burakbalci51/G-Mod-l-Enerji-zleme/TEKNİK RAPOR.docx

TEKNİK RAPOR

ESP32 + Home Assistant Tabanlı Akıllı Enerji Sayacı Tasarımı, Üretimi ve Entegrasyonu

Hazırlayan: Burak Balcı
Konu: Konut/Ofis genelinde elektrik tüketiminin ölçülmesi, görselleştirilmesi ve analiz edilmesi amacıyla geliştirilen IoT tabanlı akıllı enerji sayacı sistemi
Kapsam: Donanım tasarımı, montaj, güvenlik yaklaşımı, ESPHome ile Home Assistant entegrasyonu, saha kurulumu ve dashboard yapılandırma prensipleri

1. Amaç ve Gerekçe

Bu çalışmanın amacı; konut veya ofis ortamında elektrik tüketimini anlık ve geçmişe dönük olarak izlemeyi mümkün kılan, yerel ağ üzerinde çalışan ve mobil uygulama üzerinden erişilebilen akıllı enerji sayacı sistemi geliştirmektir. Enerji verimliliği ve maliyet optimizasyonu açısından temel yaklaşım, tüketimin ölçülebilir ve analiz edilebilir hâle getirilmesidir. Bu sistem ile:

- Anlık güç tüketimi (W)
- Enerji tüketimi (Wh / kWh)
- Gerilim (V), akım (A), frekans (Hz) ve güç faktörü (PF)
- Günlük/haftalık/aylık/yıllık trendler

Home Assistant üzerinden izlenebilmekte, grafiklerle raporlanabilmekte ve tüketim karakteristikleri çıkarılabilmektedir.

2. Sistem Genel Mimarisi

Sistem üç ana bileşenden oluşmaktadır:

1. Ölçüm Katmanı (Enerji Ölçüm Modülü): AC ölçümler için JSY-MK-194G enerji ölçüm modülü kullanılmıştır. Modül; akım pensesi (CT clamp) ile akımı, izolasyonlu transformatör ile şebeke gerilimini ölçmekte ve dahili hesaplama devreleri üzerinden güç/enerji parametrelerini üretmektedir.
2. İletişim ve Veri Katmanı (Mikrodenetleyici): ESP32 mikrodenetleyici; Modbus protokolü üzerinden ölçüm modülünden verileri okumakta ve WiFi üzerinden Home Assistant’a iletmektedir.
3. Görselleştirme ve Analiz Katmanı (Home Assistant + Dashboard): Home Assistant üzerinde sensör verileri kaydedilmekte, istatistiksel hesaplamalar yapılmakta ve kullanıcıya dashboard üzerinden sunulmaktadır. Ek olarak cihaz üzerinde bir OLED ekran ile anlık değerler yerel olarak görüntülenmektedir.

3. Kullanılan Malzemeler ve Araçlar

3.1. Elektronik Bileşenler

- JSY-MK-194G enerji ölçüm modülü (CT clamp dahil)
- ESP32 Wemos D1 Mini geliştirme kartı
- Meanwell APV-8-5 (5V, 8W) güç kaynağı
- SSD1306 0.96” I2C OLED ekran
- Perfboard (delikli pertinaks)
- 26 AWG silikon kılıflı kablo, tek damarlı bakır tel
- 2.54 mm jumper konnektörler (erkek/dişi)
- 4-pin JST XH 2.54 mm PCB konnektörü (dişi soket ve kablolu set)
- 2-pin 5.08 mm klemens terminal blok
- Isı büzüşmeli makaron
- Fişli güç kablosu (geri dönüştürülebilir)

3.2. Mekanik / Montaj Malzemeleri

- 3D baskı muhafaza ve kapak (alternatif: elektrik buatı)
- M3 pirinç dişli insertler (brass threaded inserts)
- M3x10 mm vidalar
- (Opsiyonel) Kablo rakoru (cable gland)

3.3. Araçlar

- Havya (insert yerleştirme için yaklaşık 230°C)
- Sıcak silikon
- Tornavida, pense ve temel el aletleri

4. AC Enerji Ölçümünün Teknik Dayanağı

AC sistemlerde güç hesabı, DC sistemlere göre daha karmaşıktır. DC’de güç P=V×I iken, AC’de yük tipine bağlı olarak güç faktörü değişmekte ve gerçek güç/enerji hesabı bu bileşenle birlikte değerlendirilmelidir. Bu nedenle ölçüm doğruluğu ve güvenilirliği için doğrudan akım pensesini ESP32’ye bağlayarak hesap yapmak yerine, güç faktörünü de dikkate alan bir enerji ölçüm modülü kullanılmıştır.

JSY-MK-194G modülü; ölçtüğü akım ve gerilim verilerinden hareketle güç, enerji ve ilgili parametreleri dahili olarak üretmekte ve Modbus üzerinden dış bir kontrol birimi (ESP32) tarafından okunabilir hâle getirmektedir. Bu yaklaşım; yazılım tarafını sadeleştirir, hatayı azaltır ve ölçüm tutarlılığını artırır.

5. Elektronik Bağlantı Tasarımı

5.1. Düşük Gerilim ve Haberleşme Bağlantıları

- ESP32’nin 3V3 ve GND pinleri ölçüm modülünün VCC ve GND terminallerine bağlanmıştır.
- Modbus iletişimi için:
  - Modül TX → ESP32 GPIO16
  - Modül RX → ESP32 GPIO17
- OLED ekran bağlantıları:
  - VCC → 3V3
  - GND → GND
  - SCL → GPIO22
  - SDA → GPIO21
- 5V güç kaynağı:
  - +5V → ESP32 5V girişi
  - GND → ESP32 GND

5.2. Şebeke (Mains) Bağlantıları – Güvenlik Uyarısı

Şebeke gerilimi yüksek risk içerir. Bu rapor bir “bilgilendirme ve tasarım dokümantasyonu” niteliğindedir. Uygulama yapılacaksa mevzuat, standartlar ve iş güvenliği kuralları çerçevesinde hareket edilmelidir. Şebeke tarafında işlem yapılması gerekiyorsa yetkin kişilerce uygulanmalıdır.

Şebeke bağlantı prensibi:

- Güç kablosundan gelen faz ve nötr;
  - Güç kaynağının girişine
  - Ölçüm modülünün L ve N terminallerine paralel bağlanmıştır.

6. Devre Kartı Üretimi ve Kablolama Yaklaşımı

Kalıcı ve düzenli bağlantılar için bileşenler perfboard üzerine monte edilmiştir. Uygulama adımları:

- Perfboard 54×74 mm ölçülerinde hazırlanmıştır.
- ESP32 kartına erkek pinler lehimlenmiş, perfboard üzerine dişi jumper ile oturtulmuştur.
- OLED ekran için 4-pin soket eklenmiştir.
- 5V besleme için klemens terminal kullanılmıştır.
- Ölçüm modülü bağlantısı için 4-pin JST XH konnektör konumlandırılmıştır.
- Alt tarafta izler; tek damarlı bakır tel ile, kesişen hatlar silikon kablo ile düzenlenmiştir.

Bu yaklaşım, prototip üretimde hızlı devreleme ve servis edilebilirlik sağlar. Alternatif olarak özel PCB tasarlanarak üretim kalitesi artırılabilir.

7. Muhafaza Tasarımı ve 3D Baskı Uygulaması

Elektronik bileşenlerin güvenli ve profesyonel bir yapı içinde toplanması amacıyla muhafaza Fusion 360 ile tasarlanmış ve 3D yazıcıda üretilmiştir. Tasarım kriterleri:

- Elektronik bileşenlerin yerleşimine uygun iç hacim
- OLED ekran montaj penceresi
- Kablo geçişleri için iki açıklık:
  1. CT clamp kablosu
  2. Şebeke besleme kablosu
- Kapakta estetik dalga formunda açıklıklar (pasif havalandırma katkısı)

Kablo geçişi için iki seçenek öngörülmüştür:

- Grommet/lastik geçişli kablo kullanılıyorsa yuvalı tasarım
- Standart kablo için delikli tasarım + opsiyonel kablo rakoru

3D baskı alternatifine ek olarak, sahada daha hızlı kurulum için standart elektrik buatı/kutu kullanımı da mümkündür.

8. Mekanik Montaj ve Nihai Birleştirme

Muhafaza ve kapak hazırlandıktan sonra montaj aşağıdaki sırayla tamamlanmıştır:

1. M3 pirinç insertlerin yerleştirilmesi: Insertler ~230°C havya ile tüm deliklere yerleştirilmiştir.
- Taban insertleri: bileşen montajı
- Köşe insertleri: kapak sabitleme
2. ESP32 devre kartı montajı: Kart muhafazaya yerleştirilmiş, altındaki insert konumları işaretlenerek iki montaj deliği açılmış ve kart M3x10 vidalarla sabitlenmiştir.
3. Enerji ölçüm modülü montajı: Modül 4 vida ile sabitlenmiş; düşük gerilim terminal bloğu ESP32’ye dönük konumlandırılmıştır.
4. 5V güç kaynağı montajı: İki vida ile sabitlenmiş; 5V çıkış kabloları ESP32’ye doğru yönlendirilmiştir.

Bu aşamada kablo güzergâhlarının mekanik sıkışma/ezilme riski yaratmaması ve servis edilebilir kalması esas alınmıştır.

9. Son Elektrik Bağlantıları ve Kapanış

- Güç kaynağı 5V çıkışı devre kartına bağlanmıştır.
- JST üzerinden GND, VCC, TX, RX hatları ESP32’ye bağlanmıştır (TX→16, RX→17, VCC→3V3, GND→GND).
- Şebeke bağlantılarında uygun kablo sabitleme yöntemi kullanılmış; gerekirse kablo rakoru ile mekanik emniyet sağlanmıştır.
- OLED ekran kapağa sabitlenmiş; devre kartına kısa uzatma kablosu ile bağlanmıştır.
- Kapak 4 adet M3 vida ile kapatılmıştır.

10. Home Assistant ve ESPHome Entegrasyonu

Ölçülen verilerin mobil cihazlar ve web üzerinden görüntülenebilmesi için ESP32, Home Assistant’a ESPHome eklentisi ile entegre edilmiştir.

10.1. Home Assistant Çalışma Ortamı

Home Assistant yerel ağ üzerinde çalışır. Çalıştırma seçenekleri:

- Raspberry Pi
- Mini PC
- Sanal makine (VM) üzerinde eski bir Windows PC

Yerel ağ dışından erişim için:

- Nabu Casa Cloud güvenli ve yönetilebilir bir çözüm sunar (ücretli). Alternatif yöntemler mevcuttur ancak ağ güvenliği açısından yetkinlik gerektirebilir.

10.2. ESPHome ile Cihaz Tanımlama

ESPHome üzerinden temel süreç:

- ESPHome eklentisinin kurulumu
- Yeni ESP32 cihaz kaydı (cihaz adı, şifreleme anahtarı)
- WiFi SSID/şifre tanımı
- Kararlılık için statik IP ataması (önerilir)
- Modbus sensör yapılandırması

ESPHome yapılandırmasında Modbus üzerinden farklı adreslerden okunan değerler sensörlere dönüştürülür. İhtiyaç duyulmayan sensörler Home Assistant’a gönderilmeden devre dışı bırakılabilir (örneğin sensör “name” satırı yorumlanarak).

Not: Kod parçalarının yapılandırmaya doğru girintide eklenmesi gerekir; bu rapor, kodun kendisinden çok yaklaşımı ve kurulumu tanımlamayı hedefler.

11. Sahada Kurulum (Elektrik Tesisatına Entegrasyon)

Kurulum senaryosu ülke ve standartlara göre değişebilir. Bu çalışmada amaç tüm dairenin tüketimini ölçmek olduğundan:

- Şebeke sayacından daire elektrik panosuna giden ana hat bulunmuştur.
- Akım pensesi, kabloyu kesmeye gerek kalmadan ana hat üzerine takılmıştır (açılır tip CT clamp).
- Deneme çalıştırmasında OLED ekranda güç, gerilim ve akım değerleri gözlemlenmiştir.
- Kalıcı kurulum için CT clamp kablosu yaklaşık 3 m boyunca uygun kanal/boru içerisinden taşınmıştır.
- Cihaz, ağ ekipmanlarının bulunduğu kabin bölgesine duvara sabitlenmiş; muhafaza arkasına montaj deliği açılarak duvar dübeli ile montaj yapılmıştır.
- CT clamp kablosu ölçüm modülüne bağlanmış, kapak kapatılmış ve cihaz enerji verilerek devreye alınmıştır.

12. Home Assistant Dashboard ve Analitik Çıktılar

Verilerin anlamlandırılması amacıyla Home Assistant üzerinde özel bir kontrol paneli oluşturulmuştur. Panelde:

- Anlık güç tüketimi
- Son 24 saatlik saatlik tüketim eğrisi (min–max dahil)
- Son 7 gün / 28 gün / 365 gün tüketim özetleri
- İleri seviye izleme için gerilim/akım/frekans/güç faktörü

Yaklaşım olarak:

- “Utility Meter” türü yardımcılar ile günlük sıfırlanan sayaçlar oluşturulabilir (00:00’dan itibaren tüketim).
- Daha geniş dönemli tüketimler ve min–max gibi metrikler için “statistics” sensörleri kullanılabilir (kayıt/recorder verisi gerektirir).
- Dashboard tarafında HACS kartları ile gelişmiş grafik ve düzenleme sağlanabilir (örn. apexcharts).

Bu yapı; tüketimin zaman içindeki davranışını ortaya koyarak taban yük, gereksiz tüketim ve enerji optimizasyonu noktalarının tespitini kolaylaştırır.

13. Sonuç ve Değerlendirme

Bu çalışma sonucunda:

- Konut/ofis ölçeğinde enerji tüketimi görünür hâle getirilmiş, ölçüm verileri kaydedilebilir ve analiz edilebilir şekilde toplanmıştır.
- ESP32 + ESPHome + Home Assistant kombinasyonu ile ölçeklenebilir ve geliştirilebilir bir IoT altyapısı kurulmuştur.
- 3D baskı muhafaza ile cihazın fiziksel bütünlüğü, güvenliği ve profesyonel görünümü artırılmıştır.
- Sistem; bakım, revizyon ve ürünleştirme adımlarına uygun, modüler bir mimariye sahiptir.

14. Notlar ve Sınırlar (Kurumsal Güvenlik ve Sorumluluk Çerçevesi)

- Şebeke gerilimi ile çalışma yüksek risk içerir. Uygulama sırasında ilgili mevzuat ve iş güvenliği kurallarına uyulmalıdır.
- Bu doküman; bir ürünün teknik yaklaşımını ve entegrasyon prensiplerini açıklayan rapor niteliğindedir. Sahada uygulama gerektiren adımlarda yetkin personel kullanımı esastır.
- Home Assistant’a dış ağdan erişimde güvenlik kritik olduğundan, yönetilebilir ve güvenli çözümler tercih edilmelidir.
