burakbalci51/G-Mod-l-Enerji-zleme/TEKNOPARK AR.docx

TEKNOPARK AR-GE KPI SONUÇ RAPORU

ESP32 + Home Assistant Tabanlı Akıllı Enerji Sayacı Geliştirme Çalışması

Kurum/Proje Sahibi: BLC Robotics / Burak Balcı
Uygulayıcı Birim: Teknopark Ar-Ge Ekibi
Rapor Türü: KPI Bazlı Sprint / Teslimat Sonuç Raporu
Kapsam: Donanım tasarımı, prototipleme, muhafaza üretimi, entegrasyon ve doğrulama
Hazırlayan: Burak Balcı (Proje Yöneticisi / Sistem Müh.)

1. Yönetici Özeti

Bu rapor; Teknopark bünyesindeki Ar-Ge ekibine tanımlanan KPI’lar doğrultusunda, konut/ofis ölçeğinde elektrik tüketiminin anlık ve periyodik izlenmesini sağlayan ESP32 + Home Assistant tabanlı Akıllı Enerji Sayacı prototipinin geliştirilmesi, entegrasyonu ve doğrulama faaliyetlerinin sonuçlarını sunar.

Proje; ölçüm modülü (JSY-MK-194G) üzerinden elde edilen enerji parametrelerinin Modbus ile okunarak ESP32 üzerinden WiFi ile Home Assistant’a aktarılması, OLED ekran ile yerel görüntüleme sağlanması ve 3D baskı muhafaza ile ürünleşmeye yakın bir form faktör oluşturulması hedefleriyle yürütülmüştür. KPI çıktıları planlanan kapsamda teslim edilmiştir.

2. KPI Seti ve Teslimat Kriterleri

Aşağıdaki KPI’lar sprint başlangıcında Ar-Ge ekibine tanımlanmıştır:

KPI-1 | Donanım Mimarisinin Oluşturulması

- Ölçüm modülü + ESP32 + OLED + 5V PSU bileşen seçimleri
- Bağlantı topolojisi ve arayüzlerin netleştirilmesi (Modbus, I2C, güç dağıtımı)

KPI-2 | Bağlantı Şeması ve Kablolama Standardı

- Pin eşleştirme tabloları
- Düşük gerilim / şebeke ayrımı ve montaj prensipleri
- Konnektör standardizasyonu (JST XH 4-pin vb.)

KPI-3 | Prototip Kart Üretimi (Perfboard) ve Montaj

- Servis edilebilir ve düzenli kablolama
- Test edilebilir prototip kart altyapısı

KPI-4 | Muhafaza Tasarımı ve Üretimi

- Fusion 360 tabanlı muhafaza tasarımı
- 3D baskı gövde + kapak (OLED penceresi, kablo girişleri, havalandırma)

KPI-5 | Nihai Montaj ve Mekanik Sabitleme

- M3 insert uygulaması
- Kartların, PSU’nun ve ölçüm modülünün sabitlenmesi
- Kablo güzergâh ve strain relief yaklaşımı

KPI-6 | Home Assistant Entegrasyonu (ESPHome)

- ESPHome cihaz tanımı
- WiFi yapılandırması ve önerilen statik IP yaklaşımı
- Modbus sensörlerinin Home Assistant’a aktarımı

KPI-7 | Saha Kurulumu ve İşlevsel Doğrulama

- CT clamp ana hat üzerine kesintisiz montaj
- Cihazın sahada sabitlenmesi
- OLED ekran ve HA sensör akışının doğrulanması

KPI-8 | Dashboard ve Analitik Çıktı

- Anlık güç + periyodik tüketim trendleri
- 24 saat / 7 gün / 28 gün / 365 gün pencerelerinde raporlama yaklaşımı
- Min-Max güç değerlerinin elde edilmesi

3. Uygulama Sonuçları ve Üretilen Çıktılar

3.1 KPI-1: Donanım Mimarisinin Oluşturulması (Tamamlandı)

Ar-Ge ekibi, AC ölçümün güç faktörü nedeniyle karmaşık oluşu dikkate alınarak JSY-MK-194G modülünü ölçüm katmanında konumlandırmış; ESP32’yi Modbus okuyucu ve WiFi köprüsü, OLED ekranı ise yerel HMI olarak tasarlamıştır. 5V besleme mimarisi Meanwell APV-8-5 ile doğrulanmıştır.

3.2 KPI-2: Bağlantı Şeması ve Standardizasyon (Tamamlandı)

Bağlantılar aşağıdaki şekilde standardize edilmiştir:

- Modbus (Enerji Modülü ↔ ESP32): TX → GPIO16, RX → GPIO17, VCC → 3V3, GND → GND
- OLED (I2C): SCL → GPIO22, SDA → GPIO21, VCC → 3V3, GND → GND
- Besleme: 5V PSU → ESP32 5V girişi + GND

Konnektörleme için 4-pin JST XH kullanımı ile saha bakım/servis kolaylaştırılmıştır.

3.3 KPI-3: Prototip Kart ve Montaj (Tamamlandı)

Perfboard üzerinde ESP32 ve OLED soketleme, 5V giriş terminali ve JST bağlantı noktaları oluşturulmuş; alt katman kablolamada tek damarlı bakır tel ile hatlar oluşturulmuş, kesişen güzergâhlarda silikon kablo kullanılmıştır. Prototip, test edilebilir ve servis edilebilir şekilde tamamlanmıştır.

3.4 KPI-4: Muhafaza Tasarımı ve 3D Baskı (Tamamlandı)

Muhafaza Fusion 360’ta tasarlanmış ve iki parça olarak üretilmiştir:

- Gövde (yeşil PLA)
- Kapak (gri PLA)

Tasarım kriterleri:

- CT clamp kablosu ve şebeke besleme kablosu için girişler
- Kablolu grommet veya standart kablo için alternatif kasa geometrileri
- OLED ekran yuvası
- Kapakta estetik + pasif havalandırma açıklıkları

Alternatif olarak 3D baskı olmadan elektrik buatı ile kurulum opsiyonu rapora eklenmiştir.

3.5 KPI-5: Nihai Montaj ve Mekanik Sabitleme (Tamamlandı)

Ar-Ge ekibi, muhafazaya M3 pirinç insertleri yerleştirerek (yaklaşık 230°C) bileşenleri vidalı montaja uygun hâle getirmiştir.

- Devre kartı: 2 adet M3x10 vida ile sabitlenmiştir
- Enerji ölçüm modülü: 4 vida ile sabitlenmiştir (LV terminal ESP32’ye dönük)
- 5V PSU: 2 vida ile sabitlenmiş, çıkış kabloları ESP32’ye yönlendirilmiştir Kapak 4 köşe vidası ile kapatılmıştır.

3.6 KPI-6: Home Assistant Entegrasyonu (Tamamlandı)

ESPHome kullanılarak:

- Cihaz tanımı yapılmış
- WiFi kimlik bilgileri girilmiş
- Kararlılık için statik IP önerisi uygulanabilir şekilde dokümante edilmiştir
- Modbus sensörleri Home Assistant’a aktarılacak şekilde yapılandırılmıştır İhtiyaç dışı sensörlerin devre dışı bırakılabilmesi (comment yaklaşımı) dokümana işlenmiştir.

3.7 KPI-7: Saha Kurulumu ve İşlevsel Doğrulama (Tamamlandı)

Ana hattın geçtiği uygun noktada CT clamp montajı kabloyu kesmeden gerçekleştirilmiştir. Cihaz, saha koşullarına göre kabin/pano bölgesine sabitlenmiş; kablo güzergâhı kanal içinde taşınmış ve sistem enerji verilerek doğrulanmıştır. OLED üzerinde anlık değerler görülmüş; Home Assistant tarafında sensör akışı doğrulanmıştır.

3.8 KPI-8: Dashboard ve Analitik Çıktılar (Tamamlandı)

Dashboard’da aşağıdaki görünürlük sağlanmıştır:

- Anlık güç tüketimi
- 24 saatlik saatlik trend (min-max dahil)
- 7 gün / 28 gün / 365 gün tüketim pencereleri
- İleri parametreler: V, A, Hz, PF

Yardımcılar (Utility Meter) ve istatistik sensörleri (statistics) ile tüketim pencereleri oluşturulabilecek şekilde yapılandırma yaklaşımı rapora eklenmiştir.

4. Güvenlik ve Uyum Notları

- Şebeke gerilimi bağlantıları yüksek risk içerir. Proje dokümantasyonunda düşük gerilim ve şebeke tarafı ayrımı açık şekilde yapılmış, saha uygulamalarında yetkin personel yaklaşımı esas alınmıştır.
- Yerel ağ dışı erişimde güvenlik kritik olduğundan Nabu Casa Cloud gibi yönetilebilir çözümler önerilmiş; ileri seviye alternatif yöntemlerin yalnızca yetkin ekiplerce uygulanması not edilmiştir.

5. Sonuç ve Kabul Kriteri

Tanımlanan KPI’lar kapsamında; donanım prototipi, muhafaza, montaj, ESPHome entegrasyonu, saha doğrulaması ve dashboard yaklaşımı başarıyla tamamlanmış ve teslim edilmiştir. Proje; PoC seviyesinden ürünleştirmeye geçiş için uygun bir temel sağlamaktadır.

Kabul Durumu: KPI-1 … KPI-8 Tamamlandı / Teslim Edildi

Sonraki Adımlar (Öneri):

- Perfboard yerine revizyon-1 PCB tasarımı
- EMC/izolasyon ve kablo güvenliği açısından iyileştirmeler
- Seri üretim montaj kılavuzu (SOP) ve test prosedürü
- Uzaktan güncelleme ve cihaz kimliklendirme standardı
- Autkey yazılım ve tamperleme sistemi(Cihaz konum değişikliğinde ve çalınma durumlarında alarm ve uyarı sistemleri)

Akıllı Enerji Sayacı Projesi

İleri Dönem İnovasyon Fikirleri ve Ar-Ge Yol Haritası

1. İnovasyon Yaklaşımı (Çerçeve)

Bu proje, tekil bir “enerji ölçüm cihazı” olmanın ötesinde; enerji verisi + analiz + karar + otomasyon ekseninde ölçeklenebilir bir platformdur.
İnovasyon fikirleri aşağıdaki 5 katmanda sistematik olarak üretilebilir:

1. Donanım (Hardware) İnovasyonu
2. Yazılım & Veri (Software / AI) İnovasyonu
3. Enerji Yönetimi & Otomasyon
4. Güvenlik, Hukuk ve Regülasyon Uyumu
5. Ticarileşme ve İş Modeli İnovasyonu

2. Donanım (Hardware) Tabanlı İnovasyon Fikirleri

2.1 Çok Kanallı / Modüler Ölçüm Mimarisi

- Tek CT yerine modüler CT slotları
- Pano içi her hat için tak-çıkar modül
- Aynı gateway’e 8–16 hat bağlanabilen yapı

İnovasyon Değeri:

“Tek cihaz – çok devre” mimarisi
Patent/Faydalı Model Potansiyeli: Yüksek

2.2 Tak-Çalıştır (Hot-Swap) Sensör Tasarımı

- CT clamp + kimlikli konektör
- Sensör takıldığında otomatik tanıma
- Yanlış sensör bağlanmasını engelleyen elektronik kilit

Katma Değer:
Bakım, servis ve saha kurulum süresini %50+ azaltır

2.3 Endüstriyel Versiyon (DIN Rail)

- DIN ray uyumlu kasa
- IP54 / IP65 varyant
- Endüstriyel pano montajı

Yeni Pazar:
OSB’ler, fabrikalar, AVM’ler, veri merkezleri

2.4 Enerji Hasadı (Self-Powered)

- CT üzerinden mikro enerji toplama
- Ultra düşük güç ESP32-C serisi
- Harici adaptörsüz çalışma

İnovasyon Türü:
Derin teknoloji / GreenTech
Savunma: Enerji izleyen ama enerji tüketmeyen sistem

3. Yazılım & Yapay Zekâ (AI) İnovasyonları

3.1 Cihaz Tanıma (Non-Intrusive Load Monitoring – NILM)

- Akım imzasından cihaz türü tespiti
- “Buzdolabı açıldı”, “klima devrede”
- CT sayısını artırmadan detaylı analiz

AI Değeri:
Edge AI + zaman serisi analizi
Patent Potansiyeli: Orta–Yüksek

3.2 Anomali & Kaçak Tespiti

- Normal dışı tüketim profili algılama
- Kaçak akım, eski cihaz, arızalı motor tespiti
- Kullanıcıya otomatik uyarı

Kurumsal Değer:
Yangın riski, enerji kaçağı ve fatura şoku önleme

3.3 Tahminleme (Forecasting Engine)

- Günlük/aylık tüketim tahmini
- Fatura tahmin motoru
- “Ay sonu tahmini fatura: X ₺”

Finansal Katma Değer:
Kullanıcı davranışını değiştiren veri

3.4 Edge vs Cloud AI Ayrımı

- Hassas veriler Edge’de
- Toplu analizler Cloud’da
- GDPR / KVKK uyumlu mimari

4. Enerji Yönetimi & Otomasyon İnovasyonları

4.1 Akıllı Yük Yönetimi (Smart Load Shedding)

- Pik saatlerde otomatik yük kapatma
- Elektrikli şarj, klima, rezistans önceliklendirme
- Sayaç + röle + otomasyon entegrasyonu

Yeni KPI:
kWh değil, tasarruf edilen kWh

4.2 Dinamik Tarife & Saat Bazlı Optimizasyon

- Gece/gündüz tarifesine göre öneri
- “Şu cihazı 22:00’den sonra çalıştır”

Enerji Şirketleri için Değer:
Talep dengeleme (Demand Response)

4.3 Güneş / Rüzgâr / Batarya Entegrasyonu

- Çift yönlü ölçüm (import/export)
- Güneş üretimi vs tüketim analizi
- Batarya şarj/deşarj optimizasyonu

Stratejik Etki:
Akıllı şebeke (Smart Grid) uyumu

5. Güvenlik, Hukuk ve Regülasyon İnovasyonları

5.1 Hukuki Delil Üretebilen Ölçüm

- Zaman damgalı, imzalı kayıt
- Değiştirilemez log (hash / blockchain-lite)
- Enerji uyuşmazlıklarında delil niteliği

Mahkeme & Kamu Değeri:
Çok yüksek

5.2 Anti-Tamper (Kurcalama Tespiti)

- Kapak açılma algısı
- CT çıkarılma algısı
- Ölçüm manipülasyon alarmı

Kamu & Belediyeler için kritik

5.3 Siber Güvenlik Katmanı

- Cihaz kimliği (device fingerprint)
- Secure boot + OTA
- Sahte cihaz / klon engelleme

6. Ticarileşme ve İş Modeli İnovasyonları

6.1 SaaS + Donanım Hibrit Model

- Cihaz düşük kâr
- Analiz & raporlama abonelik
- Kurumsal dashboard lisansı

6.2 B2B Enerji Raporlama Servisi

- Site yönetimleri
- OSB yönetimleri
- Belediyeler

Satılan şey cihaz değil, veri

6.3 Beyaz Etiket (White-Label) Model

- Enerji şirketlerine markasız ürün
- SDK + API satışı
- Lisans başına gelir

7. Ar-Ge KPI → Patent → Ürün Haritası (Özet)

Katman | Ar-Ge Çıktısı | Patent | Ürün
Donanım | Modüler CT | ✔️ | Endüstriyel Sayaç
Yazılım | NILM AI | ✔️ | Akıllı Analiz
Güvenlik | Anti-Tamper | ✔️ | Kamu Çözümü
Enerji | Load Shedding | ◑ | Smart Grid
İş Modeli | SaaS | ❌ | Gelir Motoru

8. Stratejik Sonuç (Teknopark & Kurul Dili)

Bu proje, yalnızca bir enerji ölçüm cihazı değil;
enerji verisini ekonomik, hukuki ve operasyonel değere dönüştüren bir platformun çekirdeğidir.

Bu yapı:

- Ar-Ge sürekliliğine uygundur
- Patent üretimine açıktır
- Kamu, sanayi ve konut pazarlarına ölçeklenebilir
- Teknopark kriterleriyle tam uyumludur

6. Ekler (Opsiyonel)

- Ek-1: Bağlantı Topolojisi ve Pin Eşleştirme Tablosu
- Ek-2: Muhafaza Tasarım Dosyaları ve Montaj Noktaları
- Ek-3: ESPHome / Home Assistant yapılandırma yaklaşımı (kurumsal repo düzeni)
- Ek-4: Saha Kurulum Notları ve Doğrulama Kontrol Listesi
