burakbalci51/G-Mod-l-Enerji-zleme/Kullandığım kaynak Youtube videosu.docx

Kullandığım kaynak Youtube videosu

https://www.youtube.com/watch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

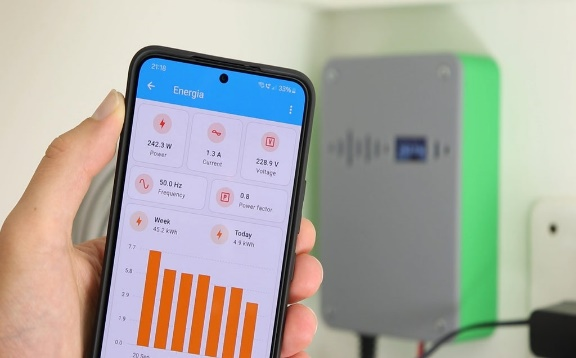
[picture p58: figure]
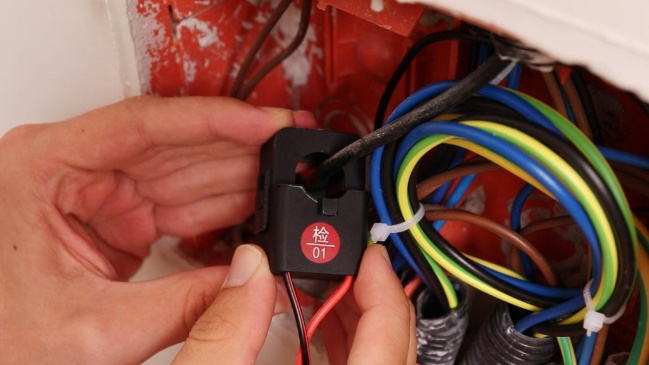
[picture p59: figure]
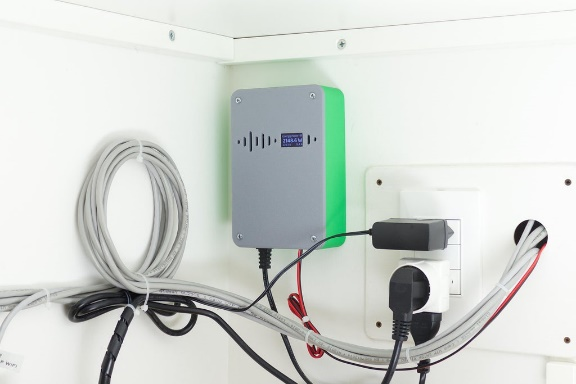
[picture p60: figure]
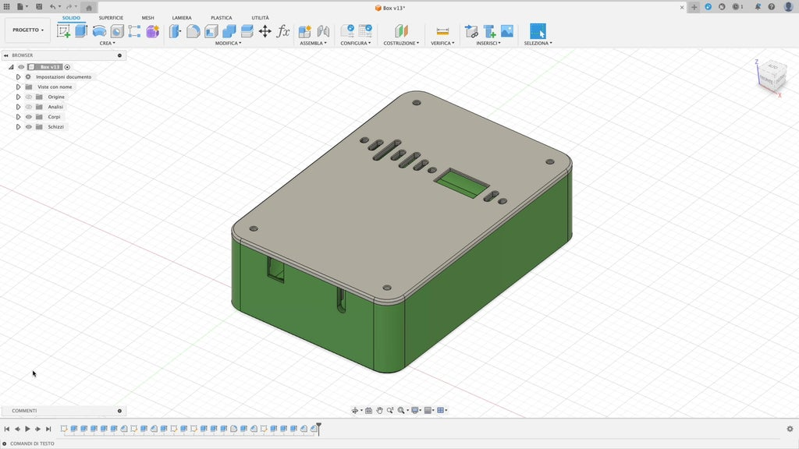
[picture p61: figure]
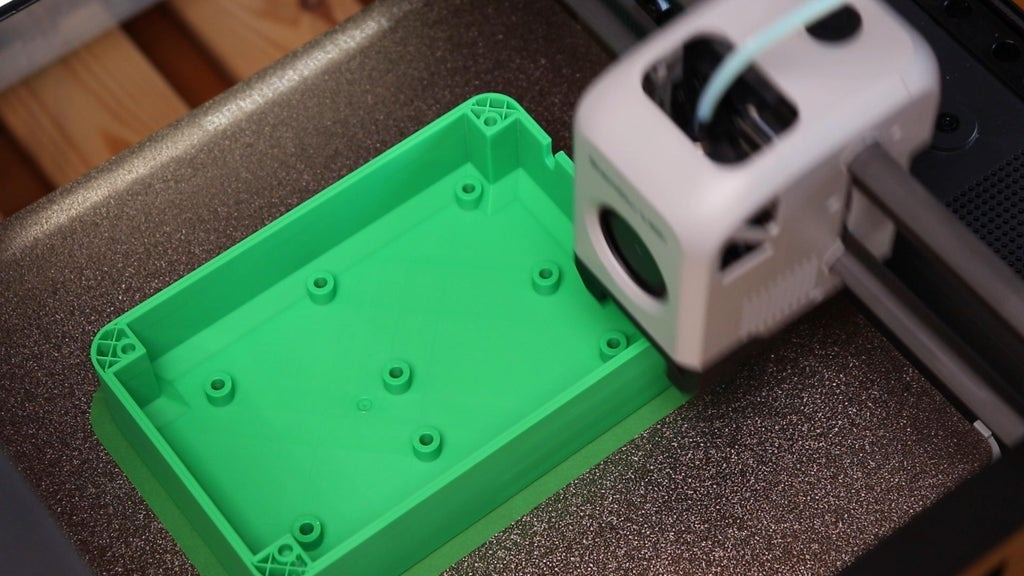
[picture p62: figure]

Harici olarak kullandığım hazır aldığım kılıf Kasa

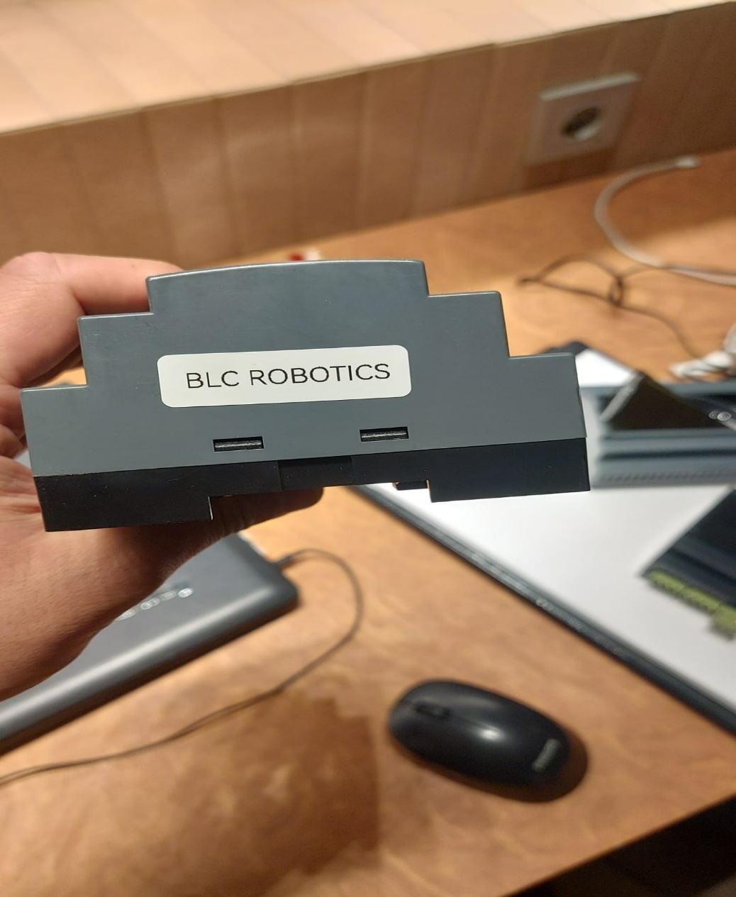
[picture p63: figure]
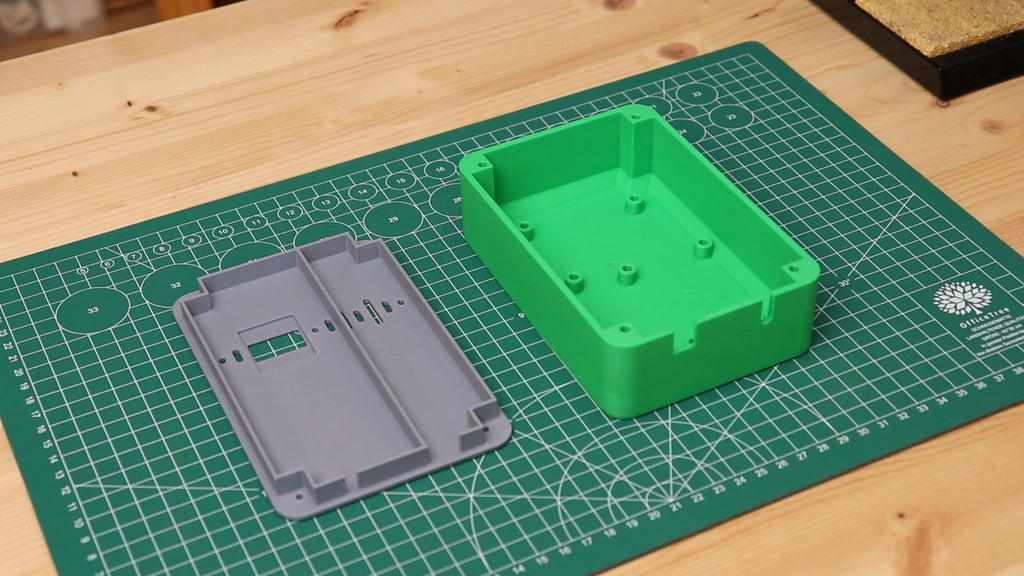
[picture p64: figure]

EK yardımcı kodlar

https://pastebin.com/NXtP9Lkq

https://pastebin.com/NXtP9Lkq
