burakbalci51/G-Mod-l-Enerji-zleme/Traces+layout.pdf

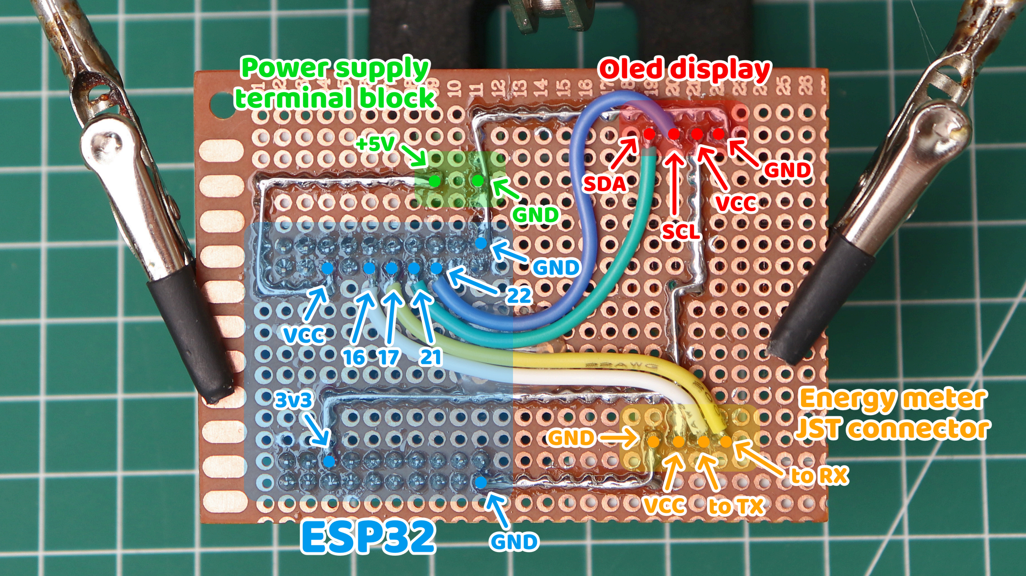
[picture p65: page 1]
