burakbalci51/G-Mod-l-Enerji-zleme/Box+(for+generic+cable).stl

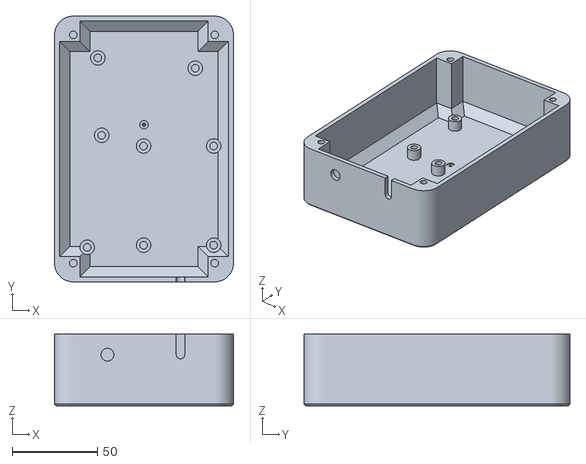
[picture p66: CAD file, 2026-01-14]
Box+(for+generic+cable).stl
104.7 x 155.5 x 42.0
