burakbalci51/G-Mod-l-Enerji-zleme/Box+(for+cable+with+grommet).stl

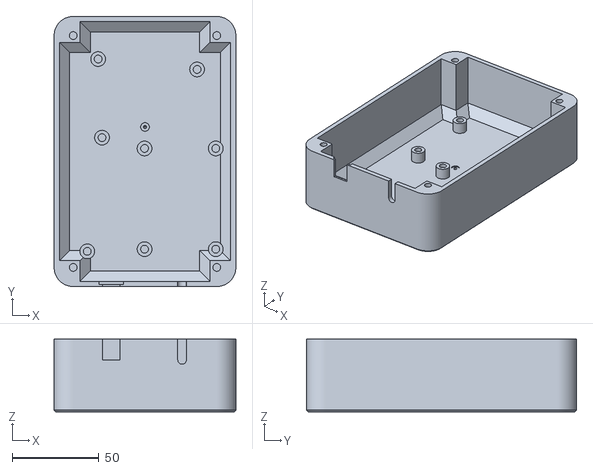
[picture p67: CAD file, 2026-01-14]
Box+(for+cable+with+grommet).stl
104.7 x 155.5 x 42.0
