burakbalci51/G-Mod-l-Enerji-zleme/Cover.stl

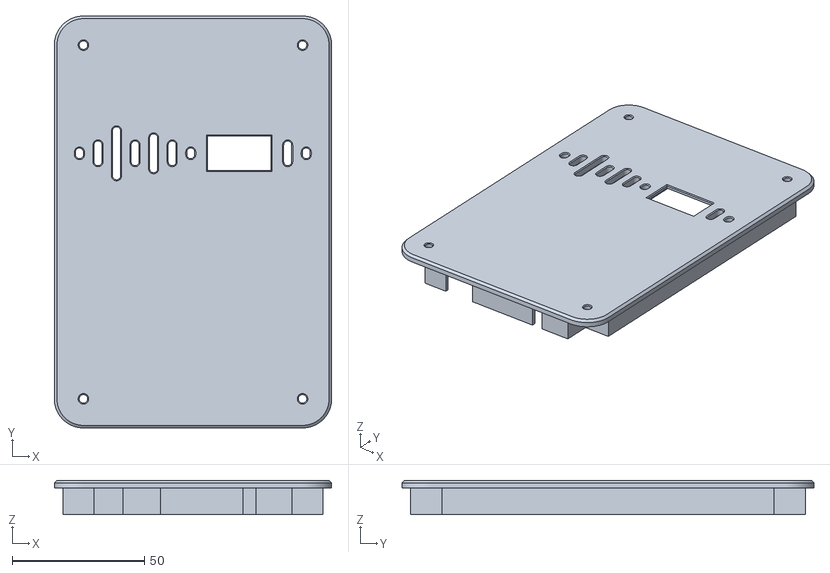
[picture p68: CAD file, 2026-01-14]
Cover.stl
104.7 x 155.5 x 13.0
