burakbalci51/G-Mod-l-Enerji-zleme/Schematic.pdf

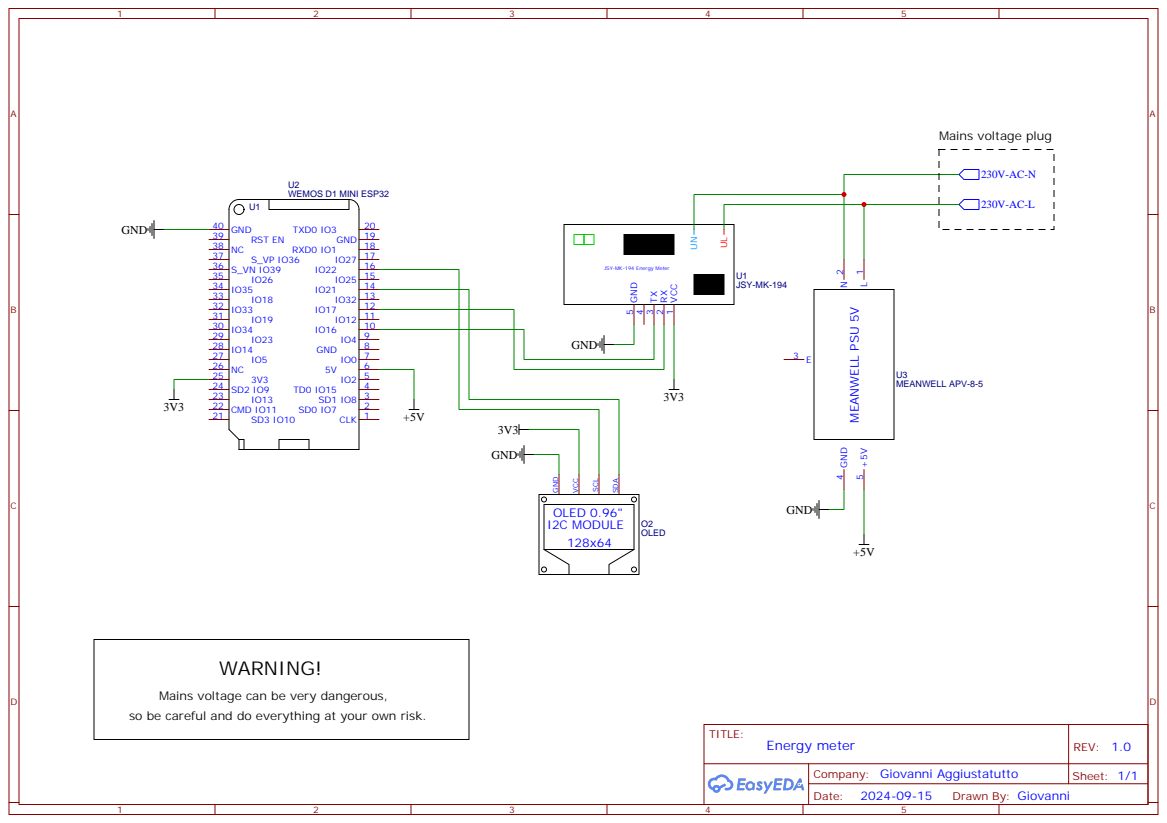
[picture p69: page 1]

JSY-MK-194 Energy Meter

Mains voltage can be very dangerous,
so be careful and do everything at your own risk.
